PaddyCube/Greenhouse/greenhouse/greenhouse.kicad_pcb

## KiCad design greenhouse/greenhouse.kicad_pcb (2023-01-20)

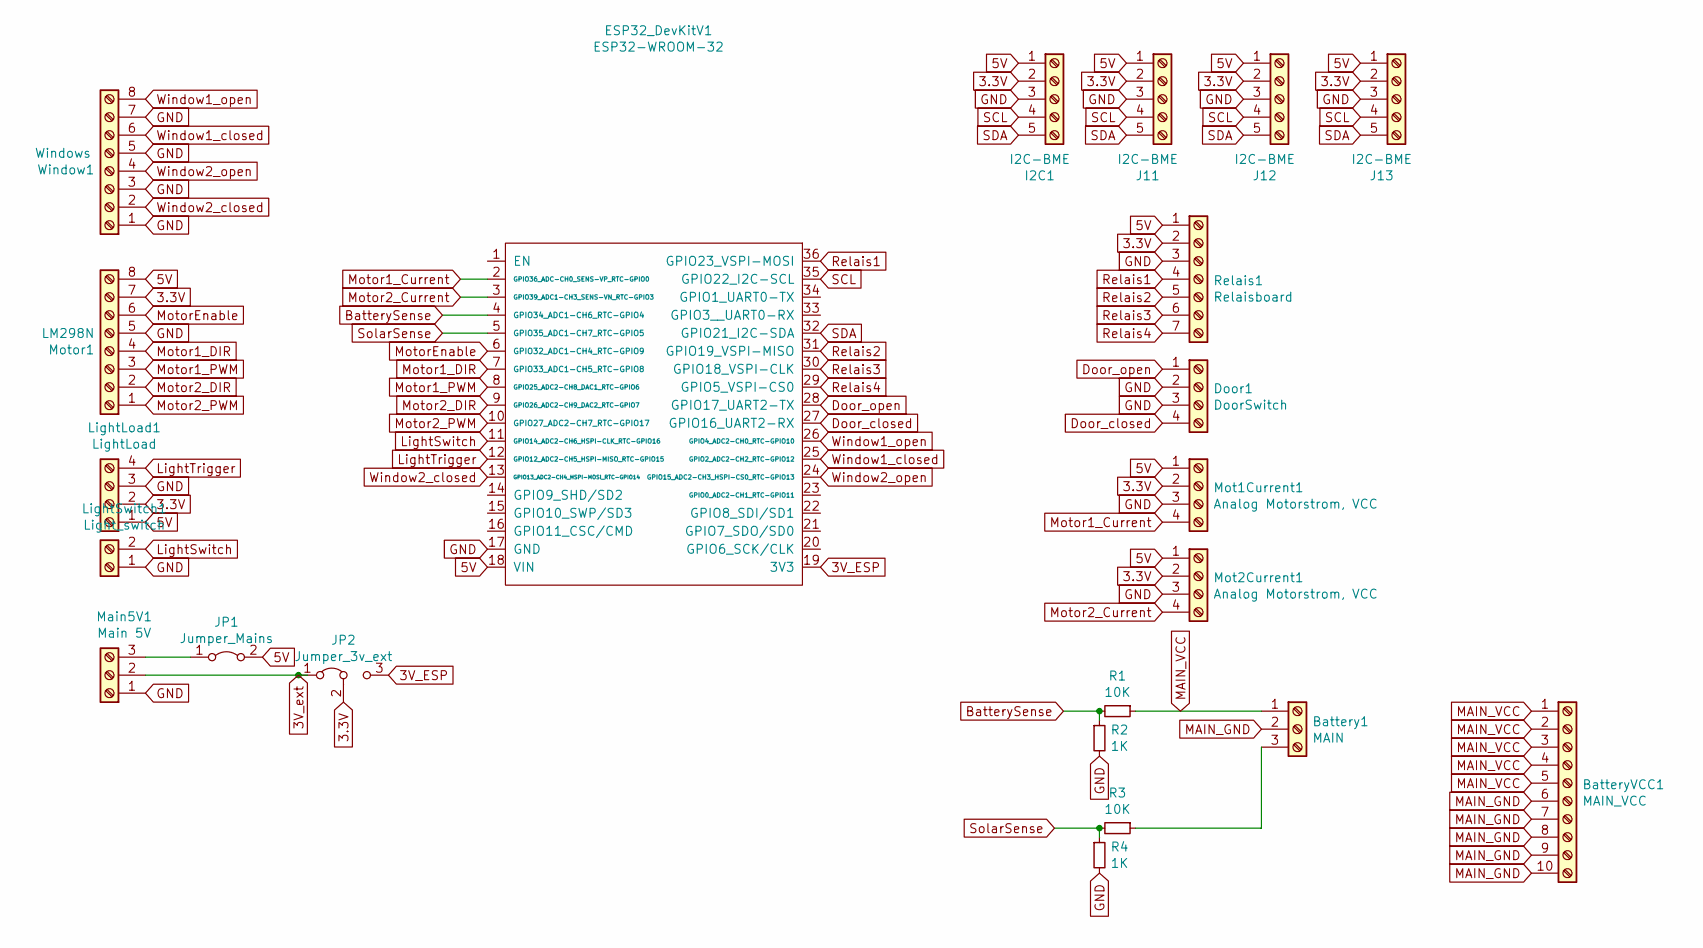
[picture p11: schematic greenhouse.kicad_sch]

Parts:
Battery1: MAIN; TerminalBlock_bornier-3_P5.08mm
BatteryVCC1: MAIN_VCC; TerminalBlock_RND_205-00240_1x10_P5.08mm_Horizontal
Door1: DoorSwitch; JST_XH_B4B-XH-A_1x04_P2.50mm_Vertical
ESP32_DevKitV1: ESP32-WROOM-32; ESP32-DOIT-DEVKIT
I2C1: I2C-BME; JST_XH_B5B-XH-A_1x05_P2.50mm_Vertical
J11, J12, J13: I2C-BME; JST_XH_B5B-XH-A_1x05_P2.50mm_Vertical
JP1: Jumper_Mains; PinSocket_1x02_P2.54mm_Vertical
JP2: Jumper_3v_ext; PinSocket_1x03_P2.54mm_Vertical
LightLoad1: LightLoad; JST_XH_B4B-XH-A_1x04_P2.50mm_Vertical
LightSwitch1: Light_switch; JST_XH_B2B-XH-A_1x02_P2.50mm_Vertical
Main5V1: Main 5V; JST_XH_B3B-XH-A_1x03_P2.50mm_Vertical
Mot1Current1, Mot2Current1: Analog Motorstrom, VCC; JST_XH_B4B-XH-A_1x04_P2.50mm_Vertical
Motor1: LM298N; JST_XH_B8B-XH-A_1x08_P2.50mm_Vertical
R1, R3: 10K; R_Axial_DIN0204_L3.6mm_D1.6mm_P7.62mm_Horizontal
R2, R4: 1K; R_Axial_DIN0204_L3.6mm_D1.6mm_P7.62mm_Horizontal
Relais1: Relaisboard; JST_XH_B7B-XH-A_1x07_P2.50mm_Vertical
Window1: Windows; JST_XH_B8B-XH-A_1x08_P2.50mm_Vertical

Connections:
3.3V: I2C1.2, J11.2, J12.2, J13.2, JP2.2 (C), LightLoad1.2, Mot1Current1.2, Mot2Current1.2, Motor1.7, Relais1.2
3V_ESP: ESP32_DevKitV1.19 (3V3), JP2.3 (B)
3V_ext: JP2.1 (A), Main5V1.2
5V: ESP32_DevKitV1.18 (VIN), I2C1.1, J11.1, J12.1, J13.1, JP1.2 (B), LightLoad1.1, Mot1Current1.1, Mot2Current1.1, Motor1.8, Relais1.1
BatterySense: ESP32_DevKitV1.4 (GPIO34_ADC1-CH6_RTC-GPIO4), R1.2, R2.1
Door_closed: Door1.4, ESP32_DevKitV1.27 (GPIO16_UART2-RX)
Door_open: Door1.1, ESP32_DevKitV1.28 (GPIO17_UART2-TX)
GND: Door1.2, Door1.3, ESP32_DevKitV1.17 (GND), I2C1.3, J11.3, J12.3, J13.3, LightLoad1.3, LightSwitch1.1, Main5V1.1, Mot1Current1.3, Mot2Current1.3, Motor1.5, R2.2, R4.2, Relais1.3, Window1.1, Window1.3, Window1.5, Window1.7
LightSwitch: ESP32_DevKitV1.11 (GPIO14_ADC2-CH6_HSPI-CLK_RTC-GPIO16), LightSwitch1.2
LightTrigger: ESP32_DevKitV1.12 (GPIO12_ADC2-CH5_HSPI-MISO_RTC-GPIO15), LightLoad1.4
MAIN_GND: Battery1.2, BatteryVCC1.6, BatteryVCC1.7, BatteryVCC1.8, BatteryVCC1.9, BatteryVCC1.10
MAIN_VCC: Battery1.1, BatteryVCC1.1, BatteryVCC1.2, BatteryVCC1.3, BatteryVCC1.4, BatteryVCC1.5, R1.1
Motor1_Current: ESP32_DevKitV1.2 (GPIO36_ADC-CH0_SENS-VP_RTC-GPIO0), Mot1Current1.4
Motor1_DIR: ESP32_DevKitV1.7 (GPIO33_ADC1-CH5_RTC-GPIO8), Motor1.4
Motor1_PWM: ESP32_DevKitV1.8 (GPIO25_ADC2-CH8_DAC1_RTC-GPIO6), Motor1.3
Motor2_Current: ESP32_DevKitV1.3 (GPIO39_ADC1-CH3_SENS-VN_RTC-GPIO3), Mot2Current1.4
Motor2_DIR: ESP32_DevKitV1.9 (GPIO26_ADC2-CH9_DAC2_RTC-GPIO7), Motor1.2
Motor2_PWM: ESP32_DevKitV1.10 (GPIO27_ADC2-CH7_RTC-GPIO17), Motor1.1
MotorEnable: ESP32_DevKitV1.6 (GPIO32_ADC1-CH4_RTC-GPIO9), Motor1.6
unnamed: Battery1.3, R3.1
unnamed: JP1.1 (A), Main5V1.3
Relais1: ESP32_DevKitV1.36 (GPIO23_VSPI-MOSI), Relais1.4
Relais2: ESP32_DevKitV1.31 (GPIO19_VSPI-MISO), Relais1.5
Relais3: ESP32_DevKitV1.30 (GPIO18_VSPI-CLK), Relais1.6
Relais4: ESP32_DevKitV1.29 (GPIO5_VSPI-CS0), Relais1.7
SCL: ESP32_DevKitV1.35 (GPIO22_I2C-SCL), I2C1.4, J11.4, J12.4, J13.4
SDA: ESP32_DevKitV1.32 (GPIO21_I2C-SDA), I2C1.5, J11.5, J12.5, J13.5
SolarSense: ESP32_DevKitV1.5 (GPIO35_ADC1-CH7_RTC-GPIO5), R3.2, R4.1
Window1_closed: ESP32_DevKitV1.25 (GPIO2_ADC2-CH2_RTC-GPIO12), Window1.6
Window1_open: ESP32_DevKitV1.26 (GPIO4_ADC2-CH0_RTC-GPIO10), Window1.8
Window2_closed: ESP32_DevKitV1.13 (GPIO13_ADC2-CH4_HSPI-MOSI_RTC-GPIO14), Window1.2
Window2_open: ESP32_DevKitV1.24 (GPIO15_ADC2-CH3_HSPI-CS0_RTC-GPIO13), Window1.4

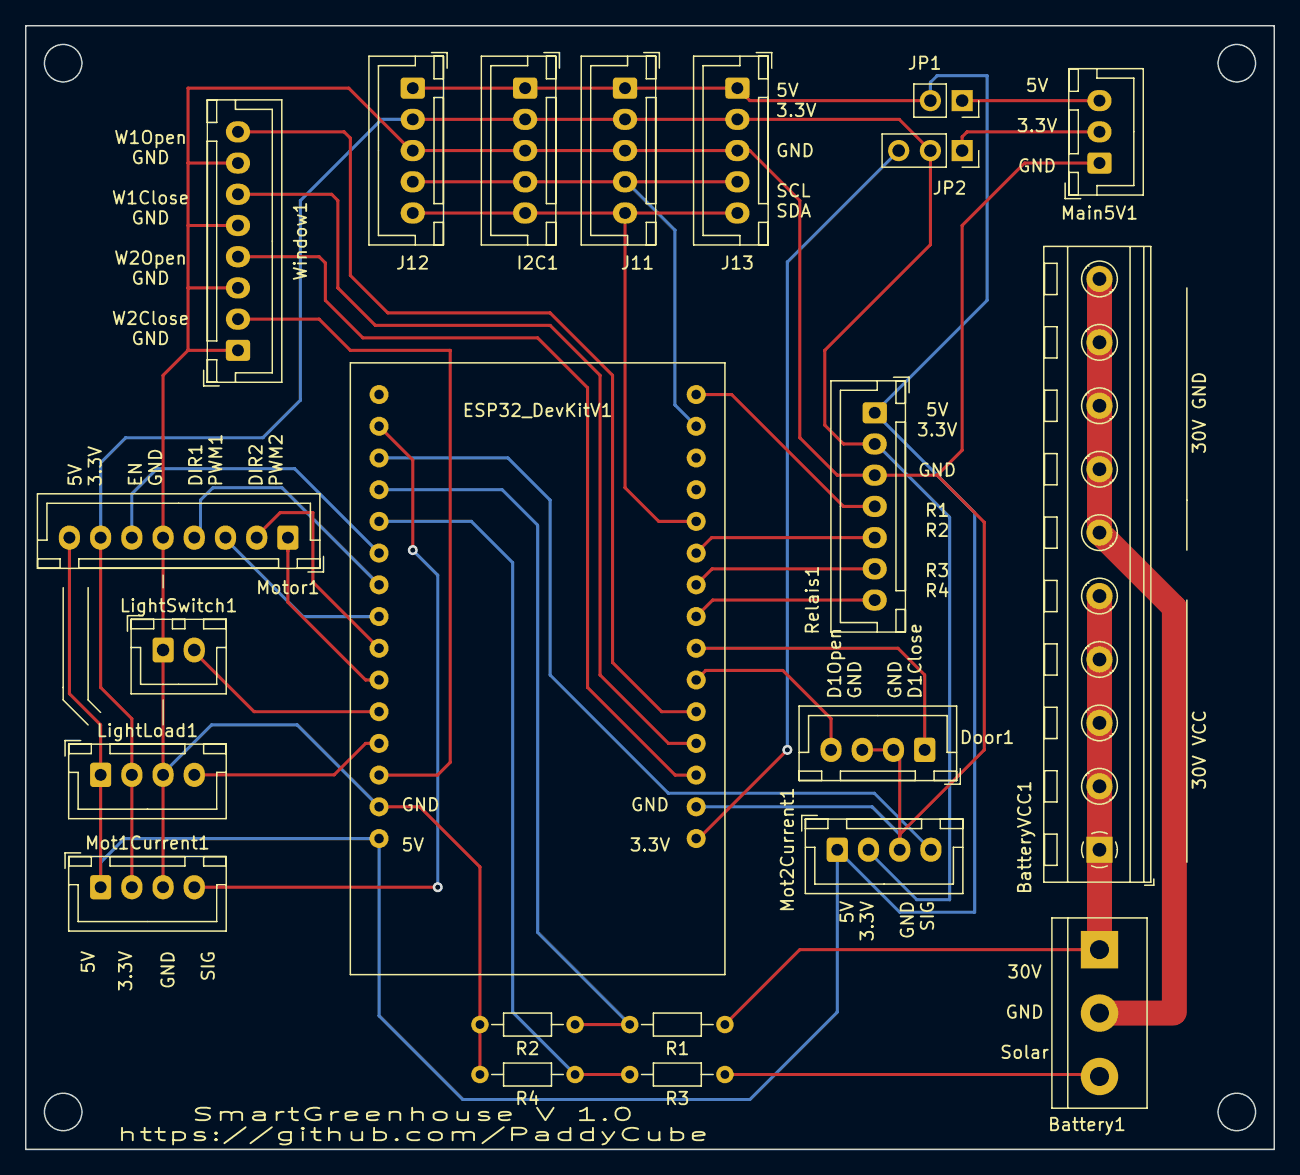
[picture p12: board greenhouse.kicad_pcb from above]

Board: 2 copper layers, 100.0 x 90.0 mm, 22 parts (0 on the bottom side), 32 nets.
