PaddyCube/Greenhouse/(commit log)

2023-01-20 rework of PCB
    [Pin-Mapping.ods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]
2023-02-08 add BME280 sensor
    [Pin-Mapping.ods]
2023-02-10 Button added
2023-03-24 fix window endstop
2023-04-05 debounce window endstops
